codage23/projet_robocup_2023/map mind du projet/mapmind des enfants.jpg

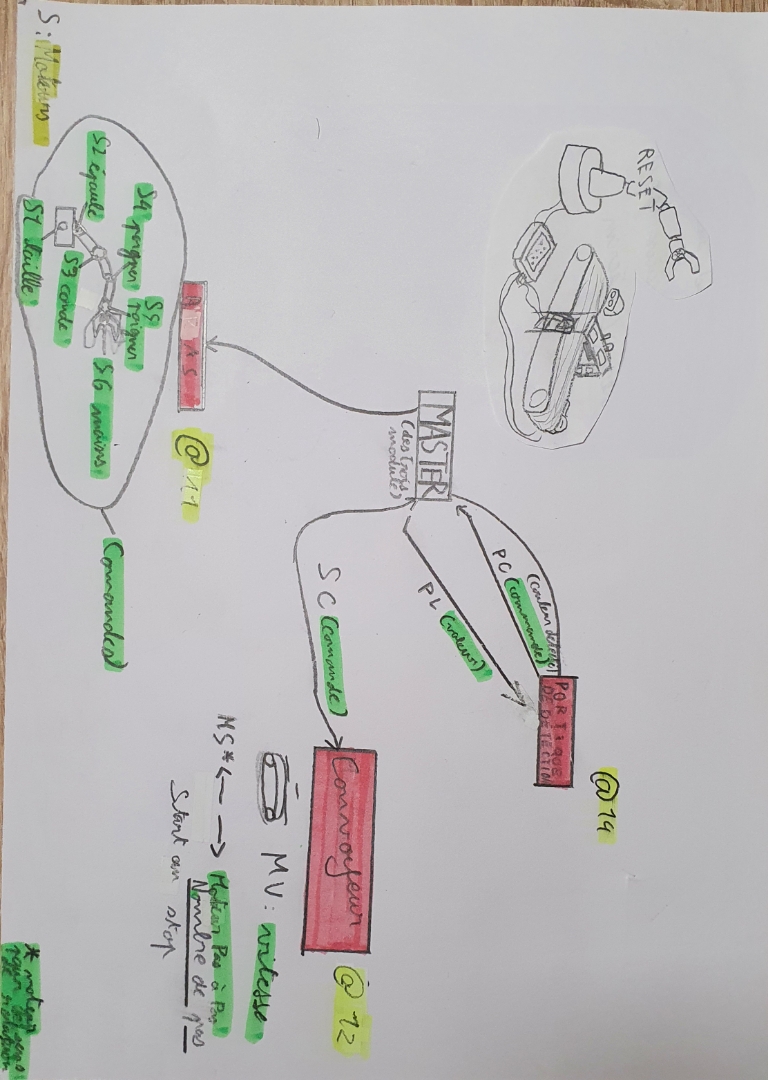
map mind du projet/mapmind des enfants.jpg
