codage23/projet_robocup_2023/projet robocup junior 2023 bras articule/projet bras articule/bras articule - liens.pdf

## Bras articule

## Liens

https://www.eagle-robotics.com/blog/4-bras-robot-6-axes-arduino---montage-et-programmation

https://learn.adafruit.com/adafruit-16-channel-pwm-slash-servo-shield?view=all

https://howtomechatronics.com/tutorials/arduino/diy-arduino-robot-arm-with-smartphone-control/
