codage23/projet_robocup_2023/projet robocup junior 2023 portique de dectection/detecteur couleurs/tcs3200_liens.pdf

TCS3200

http://electroniqueamateur.blogspot.com/2020/09/capteur-de-couleurs-tcs3200-gy-31-et.html (http://electroniqueamateur.blogspot.com/2020/09/capteur-de-couleurs-tcs3200-gy-31-et.html)

https://randomnerdtutorials.com/arduino-color-sensor-tcs230-tcs3200/

https://acoptex.com/project/2997/basics-project-078a-tcs230-or-tcs3200-color-sensor-atlex-c/ (https://acoptex.com/project/2997/basics-project-078a-tcs230-or-tcs3200-color-sensor-at-lex-c/)

https://www.electroschematics.com/get-better-with-tcs3200-color-sensor-module/

https://wiki-dfrobot-com.translate.goog/TCS3200_Color_Sensor__SKU_SEN0101_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 (https://wiki-dfrobot-com.translate.goog/TCS3200_Color_Sensor__SKU_SEN0101_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)

http://wiki.sunfounder.cc/index.php?title=Color_Sensor_Module

http://wiki.sunfounder.cc/index.php?title=TCS3200_Color_Sensor_Module

https://win.adrirobot.it/sensori/TCS3200_RGB_sensor/TCS3200_RGB_Color_Sensor.htm

https://circuitdigest.com/microcontroller-projects/interfacing-color-sensor-with-arduino

https://wiki.keyestudio.com/Ks0053_keyestudio_Color_Sensor

https://howtomechatronics.com/projects/arduino-color-sorter-project/
