codage23/projet_robocup_2023/liaisons i2c entre modules et master.pdf

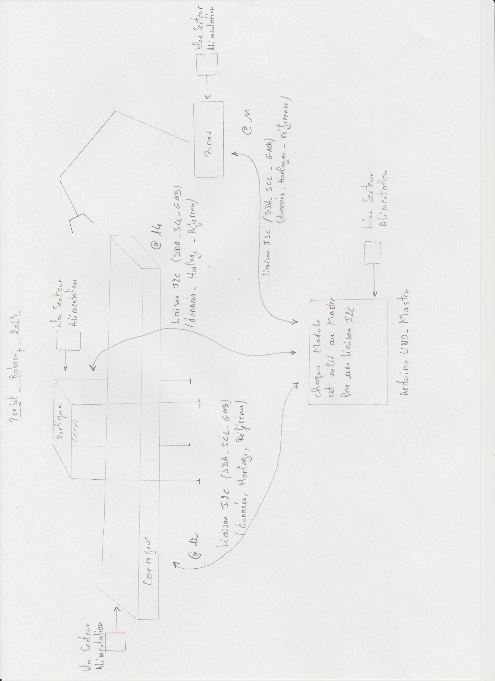
[picture p16: page 1]
