codage23/projet_robocup_2023/organigramme du projet robocup 2023.pdf

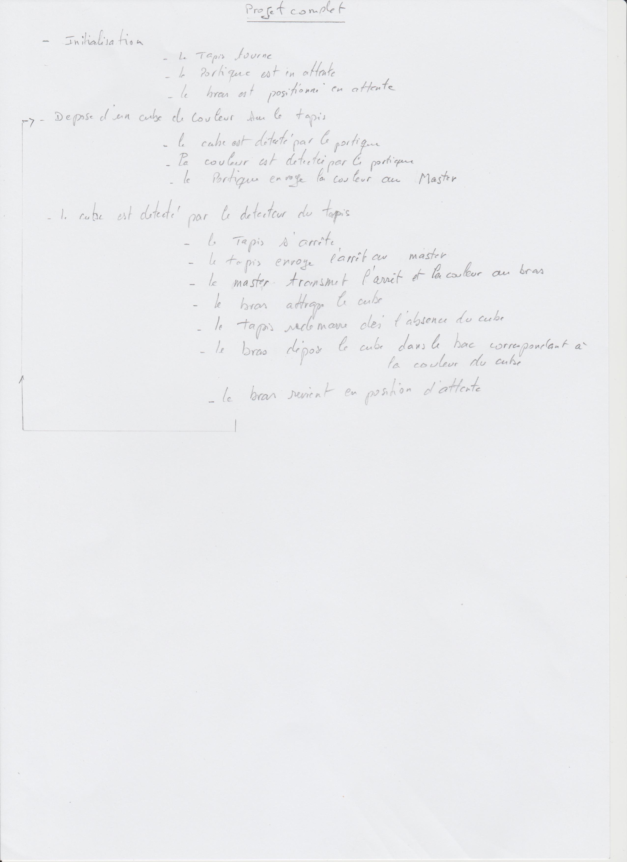
[picture p17: page 1]
