codage23/projet_robocup_2023/article_presse.pdf

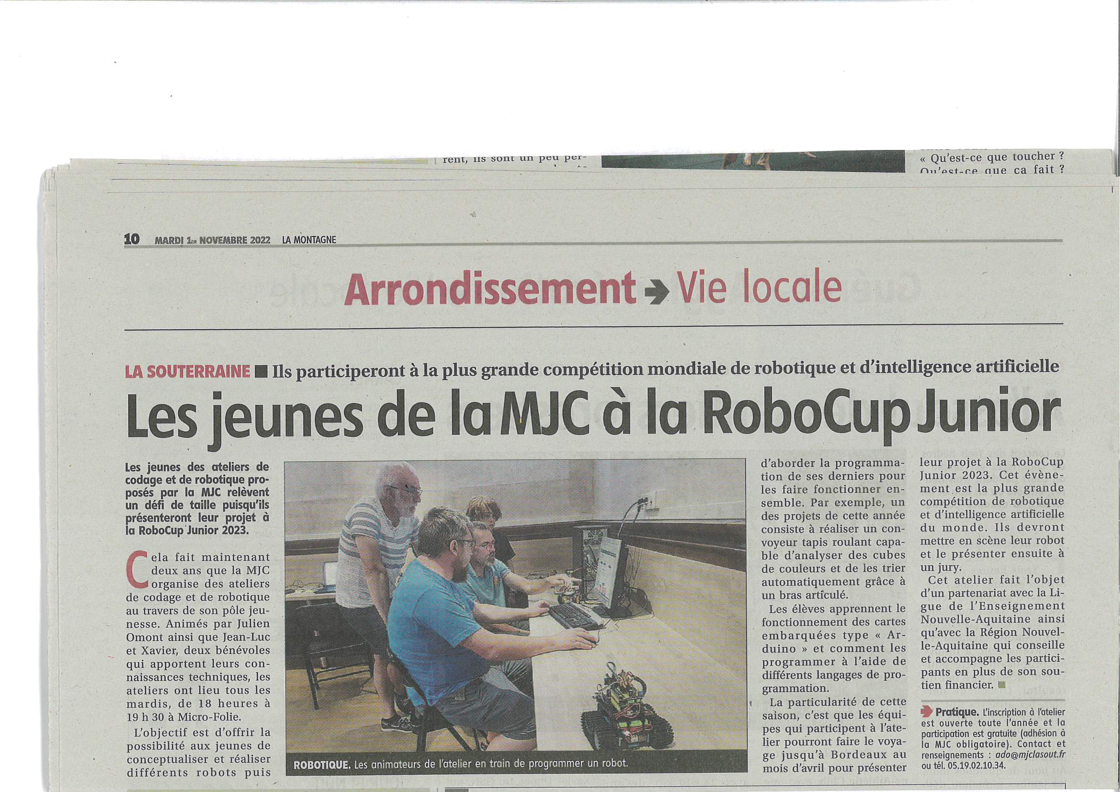
[picture p18: page 1]
