codage23/projet_robocup_2023/schema electrique/bras articule - schema electrique.pdf

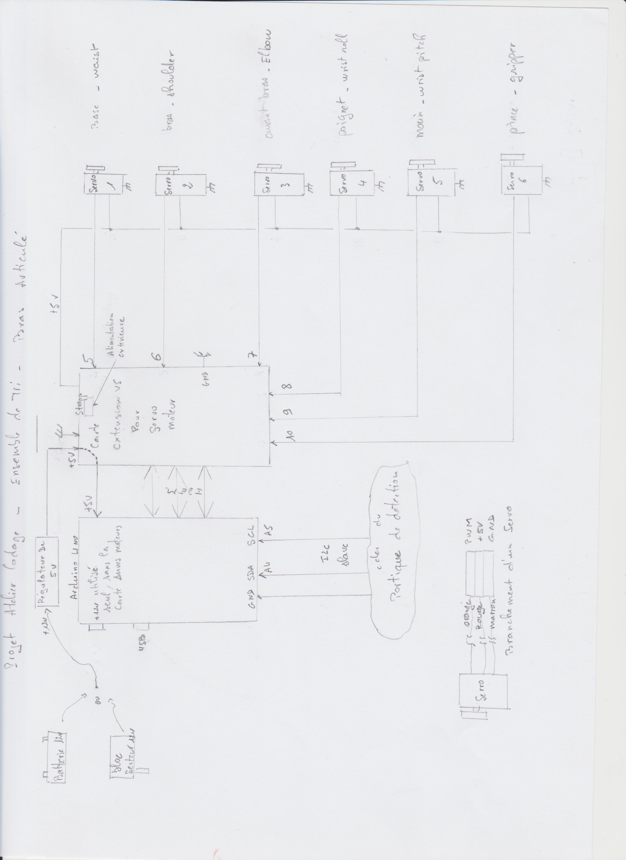
[picture p19: page 1]
