codage23/projet_robocup_2023/schema electrique/portique de detection - schema electrique.pdf

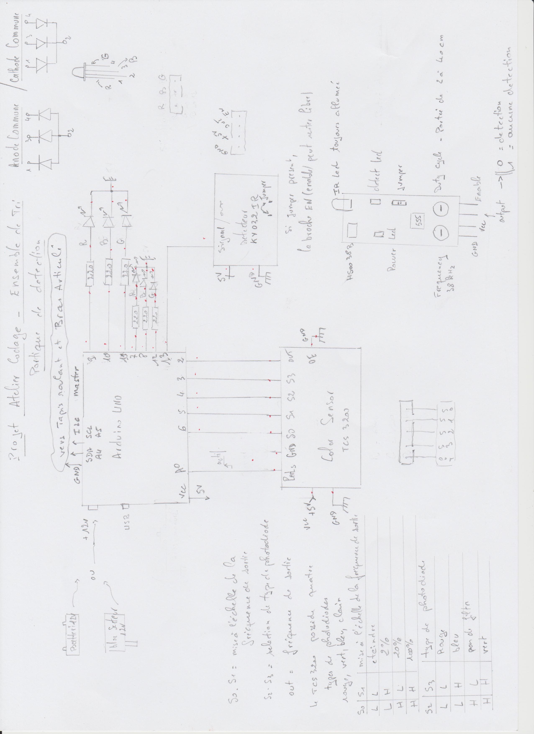
[picture p20: page 1]
