codage23/projet_robocup_2023/schema electrique/tapis roulant - convoyeur - schema electrique.pdf

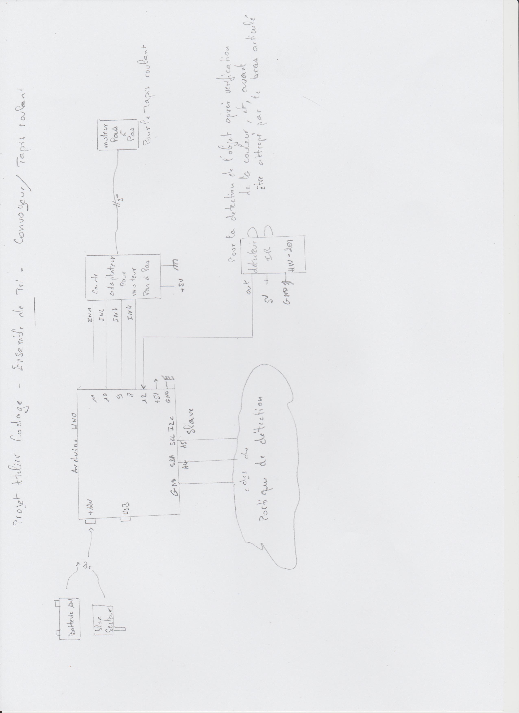
[picture p21: page 1]
