codage23/projet_robocup_2023/map mind du projet/projet atelier codage 2022 2023.pdf

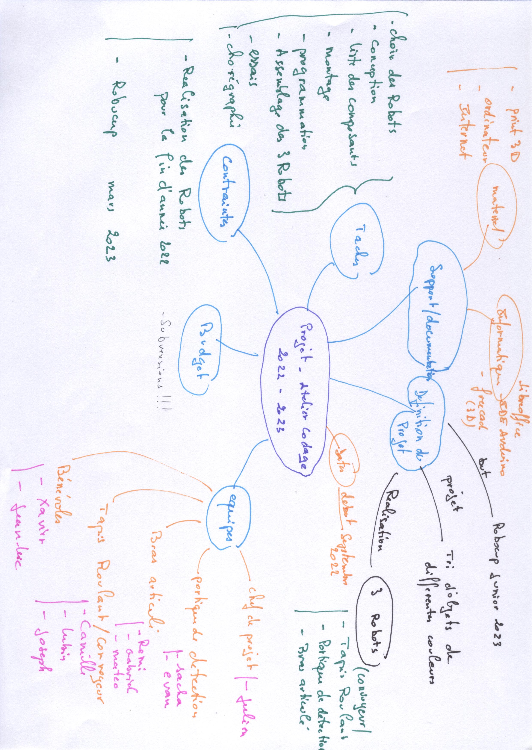
[picture p22: page 1]
