codage23/projet_robocup_2023/map mind du projet/projet atelier codage bras articule 2022 2023.pdf

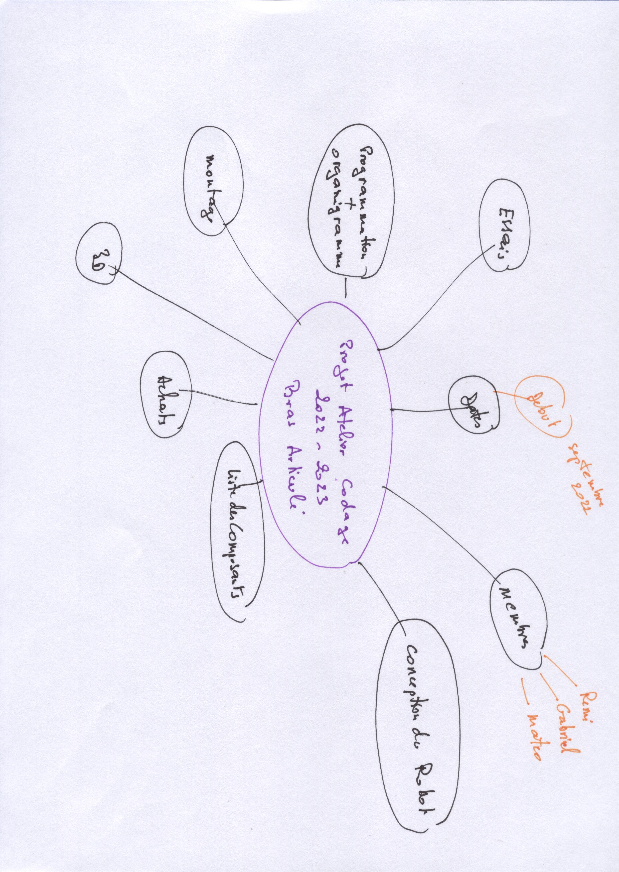
[picture p23: page 1]
