codage23/projet_robocup_2023/map mind du projet/projet atelier codage convoyeur 2022 2023.pdf

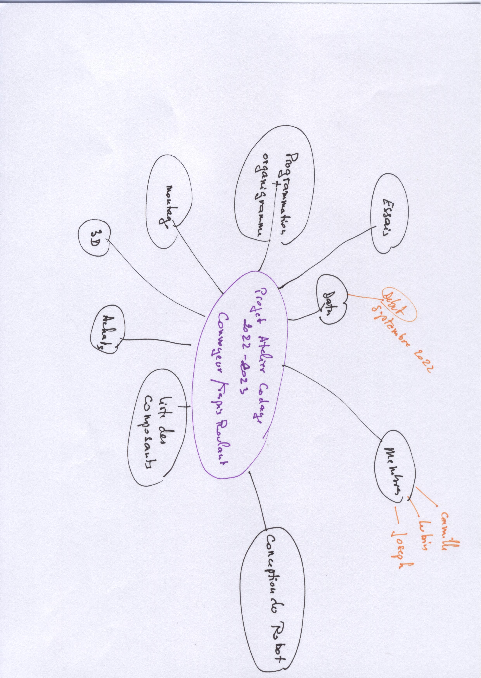
[picture p24: page 1]
