codage23/projet_robocup_2023/map mind du projet/projet atelier codage portique de detection 2022 2023.pdf

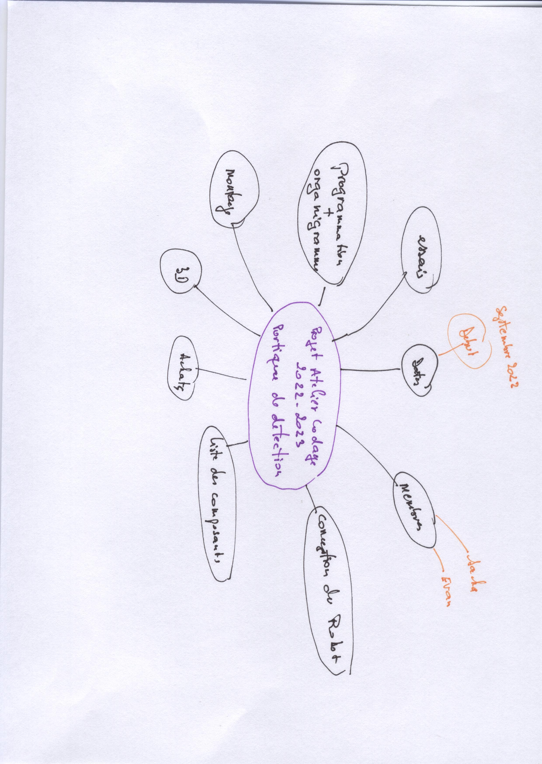
[picture p25: page 1]
