codage23/projet_robocup_2023/schema de principe/bras articule.pdf

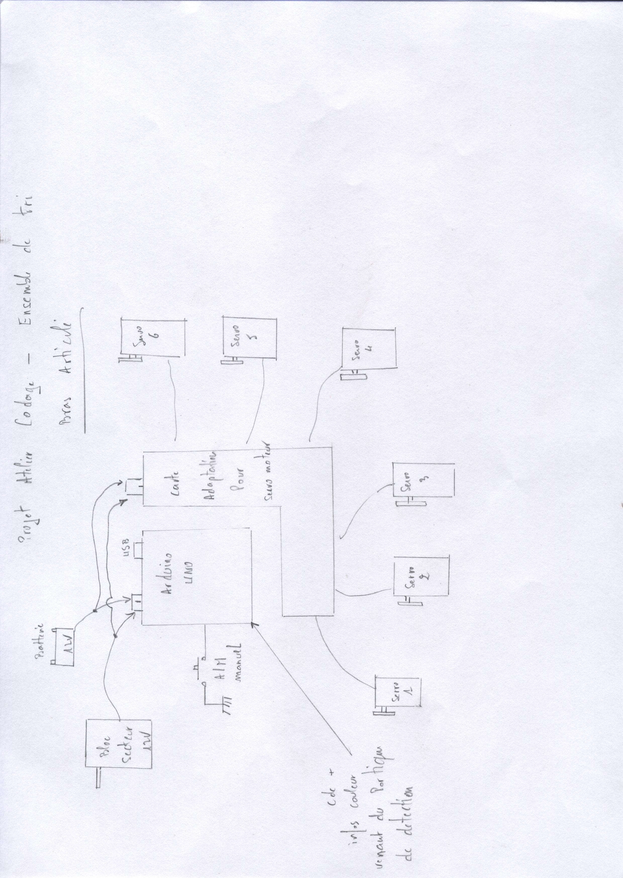
[picture p26: page 1]
