codage23/projet_robocup_2023/schema de principe/portique de detection.pdf

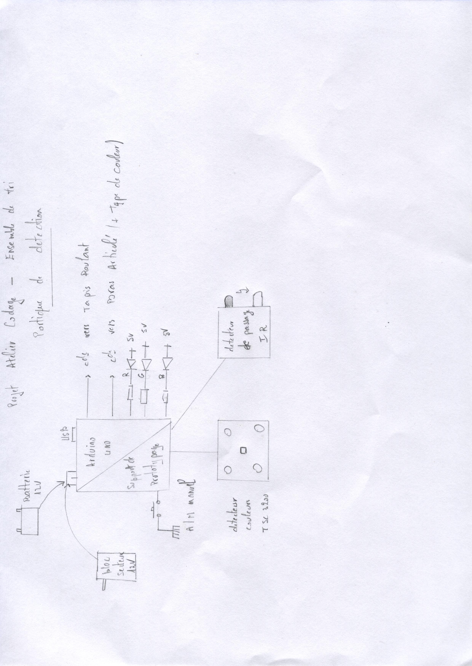
[picture p27: page 1]
