codage23/projet_robocup_2023/schema de principe/tapis roulant - convoyeur.pdf

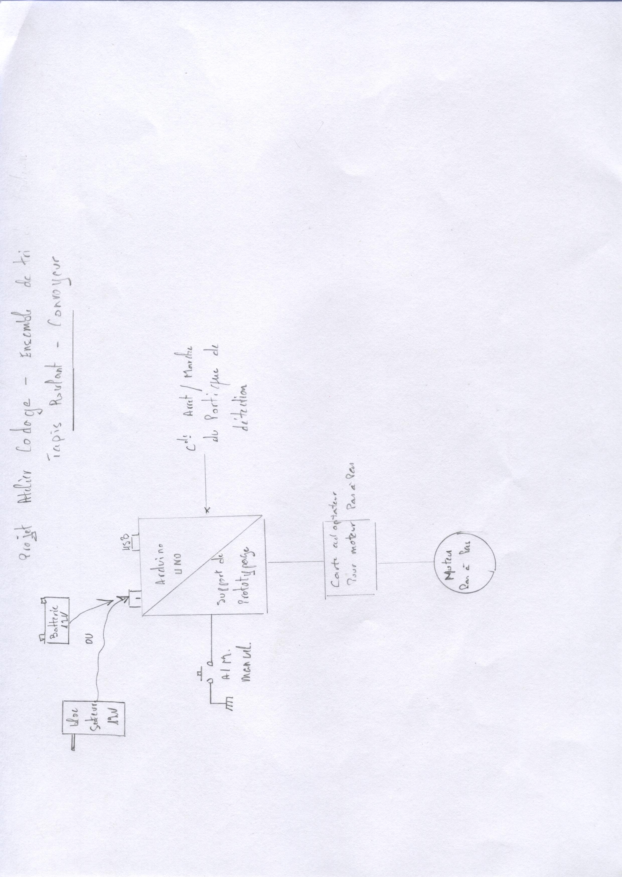
[picture p28: page 1]
