codage23/projet_robocup_2023/projet robocup junior 2023 portique de dectection/detecteur couleurs/DetectorColor.jpg

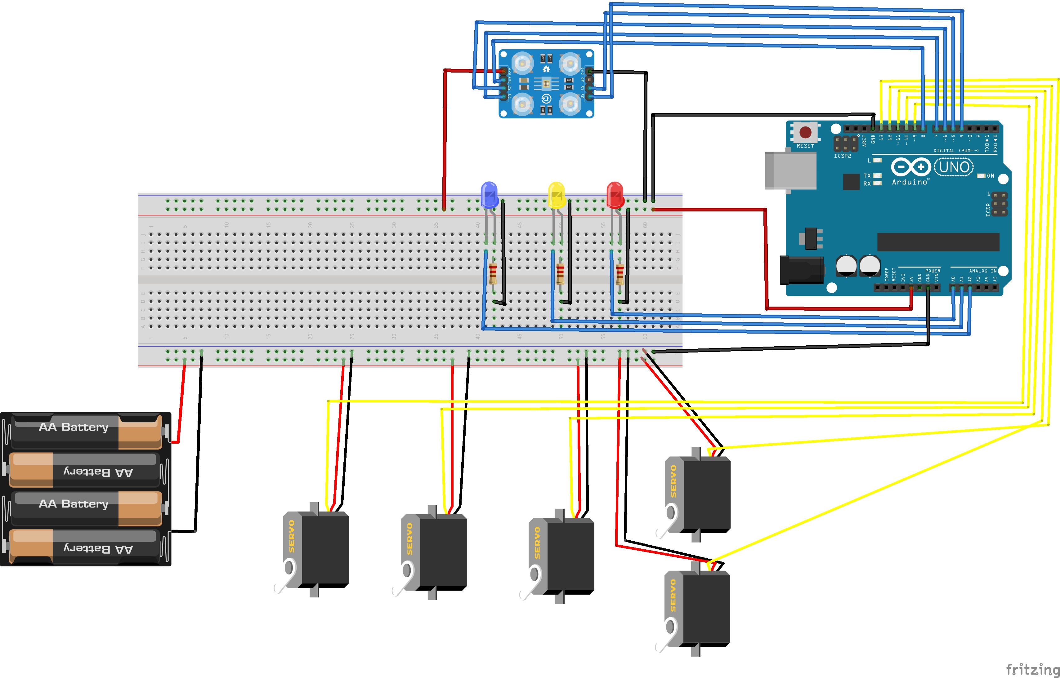
projet robocup junior 2023 portique de dectection/detecteur couleurs/DetectorColor.jpg
