codage23/projet_robocup_2023/projet robocup junior 2023 tapis roulant - convoyeur/projet convoyeur/convoyeure STL/all for the small conyor.PNG

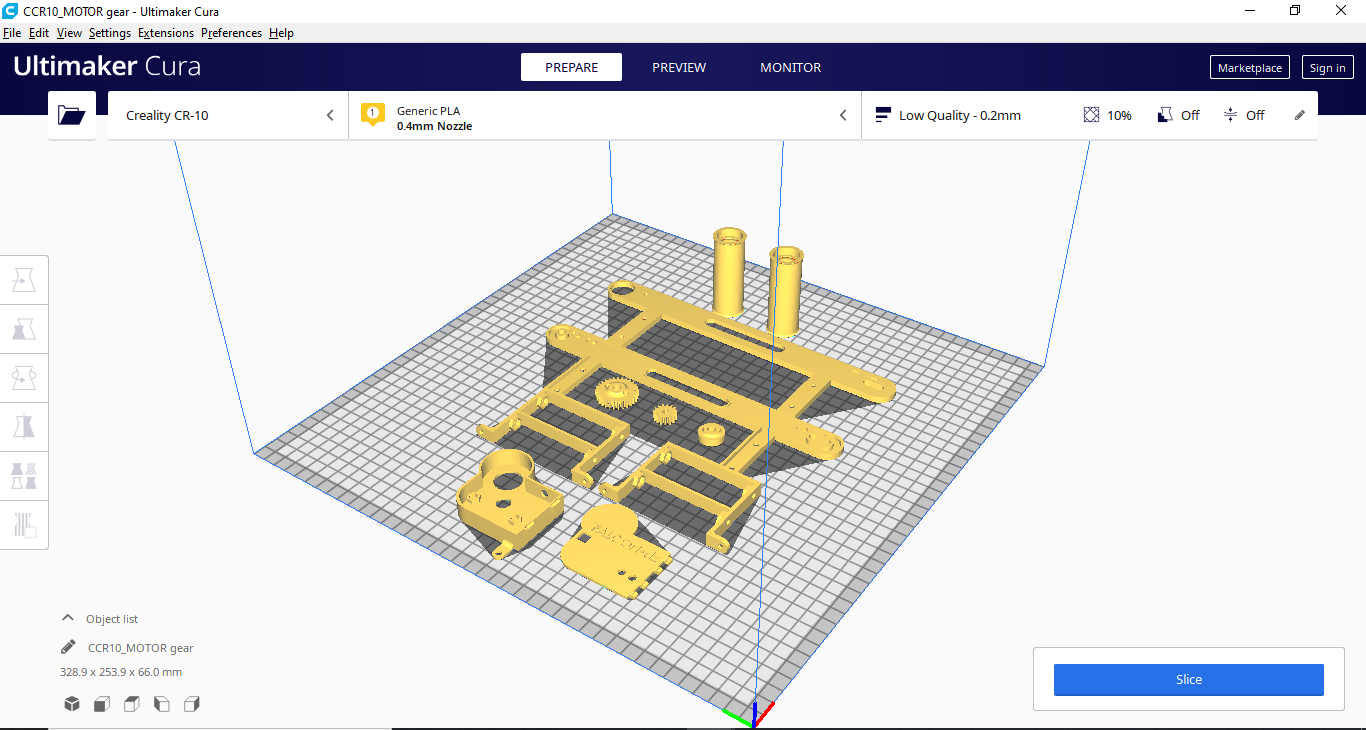
projet robocup junior 2023 tapis roulant - convoyeur/projet convoyeur/convoyeure STL/all for the small conyor.PNG
