codage23/projet_robocup_2023/achats/liste composants robocup 2022 2023.ods

nom pièce | Code produit | prix ttc | Quantite | lien
convoyeur
Carte Arduino Uno Rev3 | 1275279 - 62 | 26,99 | 1 | https://www.conrad.fr/fr/p/carte-arduino-uno-rev3-version-dip-atmega328-1275279.html
Arduino PROTO SHIELD | 1969858 - 62 | 13,99 | 1 | https://www.conrad.fr/fr/p/arduino-proto-shield-carte-de-developpement-1969858.html?vat=true
MAKERFACTORY MF-6402411 Module de commande de moteur pas à pas | 2134137 – 62 | 8,49 | 1 | https://www.conrad.fr/fr/p/makerfactory-mf-6402411-module-de-commande-de-moteur-pas-a-pas-1-pc-s-2134137.html
HN Power HNP12-120L6 Bloc d'alimentation à tension fixe 12 V/DC 1000 mA 12 W stabilisé | 1527554 – 62 | 9,49 | 1 | https://www.conrad.fr/fr/p/hn-power-hnp12-120l6-bloc-d-alimentation-a-tension-fixe-12-v-dc-1000-ma-12-w-stabilise-1527554.html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
Bearing 626 2Z Roulement | 198844 - 62 | 3,55 | 4 | https://www.conrad.fr/fr/p/ubc-bearing-626-2z-roulement-a-billes-radial-6-mm-exterieur-19-mm-regime-max-32000-tr-min-198844.html
Vis hexagonales 100 pc(s) M4 25 mm | 130626 - 62 | 6,99 | 1 | https://www.conrad.fr/fr/p/vis-hexagonales-toolcraft-130626-100-pc-s-m4-25-mm-tete-hexagonale-6-pans-exterieurs-acier-n-a-130626.html
Écrou hexagonal M4 100 pc(s) | 2287033 - 62 | 2,81 | 1 | https://www.conrad.fr/fr/p/toolcraft-to-6861099-ecrou-hexagonal-m4-din-934-acier-inoxydable-v2a-a2-100-pc-s-2287033.html
vis M3 20mm 100 pc(s) | 814733 - 62 | 2,81 | 1 | https://www.conrad.fr/fr/p/vis-cylindrique-toolcraft-814733-100-pc-s-m3-20-mm-tete-cylindrique-plat-acier-n-a-814733.html
Ecrou M3 100pcs | 2287032 - 62 | 2,81 | 1 | https://www.conrad.fr/fr/p/toolcraft-to-6861096-ecrou-hexagonal-m3-din-934-acier-inoxydable-v2a-a2-100-pc-s-2287032.html
vis M6 20mm 100pcs | 128222 - 62 | 6,49 | 1 | https://www.conrad.fr/fr/p/vis-hexagonales-toolcraft-128222-100-pc-s-m6-20-mm-tete-hexagonale-6-pans-exterieurs-acier-n-a-128222.html
Ecrou M6 100pcs | 131827 - 62 | 3,52 | 1 | https://www.conrad.fr/fr/p/ecrou-hexagonal-toolcraft-131827-acier-zingue-galvanise-de-qualite-8-m6-100-pc-s-131827.html
Bouton poussoir | 1566643 - 62 | 0,73 | 1 | https://www.conrad.fr/fr/p/tru-components-pbs-18b-701837-bouton-poussoir-a-pression-50-v-dc-ac-0-025-a-1-x-off-on-a-rappel-1-pc-s-1566643.html
tige filetee M6 85mm |  |  | 1
bras articule
Carte Arduino Uno Rev3 | 1275279 - 62 | 26,99 | 1 | https://www.conrad.fr/fr/p/carte-arduino-uno-rev3-version-dip-atmega328-1275279.html
Arduino PROTO SHIELD | 1969858 - 62 | 13,99 | 1 | https://www.conrad.fr/fr/p/arduino-proto-shield-carte-de-developpement-1969858.html?vat=true
HN Power HNP12-120L6 Bloc d'alimentation à tension fixe 12 V/DC 1000 mA 12 W stabilisé | 1527554 – 62 | 9,49 | 2 | https://www.conrad.fr/fr/p/hn-power-hnp12-120l6-bloc-d-alimentation-a-tension-fixe-12-v-dc-1000-ma-12-w-stabilise-1527554.html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
résistance 1 kohm | 1417699 – 62 | 0,08 | 10 | https://www.conrad.fr/fr/p/resistance-a-couche-carbone-yageo-cfr25j1k0h-1-k-sortie-axiale-0207-0-25-w-1-pc-s-1417699.html
servomoteur sg90 | 2148502 - 62 | 6,99 | 3 | https://www.conrad.fr/fr/p/reely-mini-servomoteur-analogique-materiau-entrainement-plastique-systeme-de-connecteur-jr-2148502.html
servomoteur mg995 | 2481920 – 62 | 11,99 | 3 | https://www.conrad.fr/fr/p/whadda-wpm603-carte-de-developpement-1-pc-s-2481920.html
Bouton poussoir | 1566643 - 62 | 0,73 | 1 | https://www.conrad.fr/fr/p/tru-components-pbs-18b-701837-bouton-poussoir-a-pression-50-v-dc-ac-0-025-a-1-x-off-on-a-rappel-1-pc-s-1566643.html
carte adaptation arduino uno servo |  |  | 1
rallonge cordon servo moteur |  |  | 6
hc05 shield bluetooth |  |  | 1
portique
Carte Arduino Uno Rev3 | 1275279 - 62 | 26,99 | 1 | https://www.conrad.fr/fr/p/carte-arduino-uno-rev3-version-dip-atmega328-1275279.html
Arduino PROTO SHIELD | 1969858 - 62 | 13,99 | 1 | https://www.conrad.fr/fr/p/arduino-proto-shield-carte-de-developpement-1969858.html?vat=true
HN Power HNP12-120L6 Bloc d'alimentation à tension fixe 12 V/DC 1000 mA 12 W stabilisé | 1527554 – 62 | 9,49 | 1 | https://www.conrad.fr/fr/p/hn-power-hnp12-120l6-bloc-d-alimentation-a-tension-fixe-12-v-dc-1000-ma-12-w-stabilise-1527554.html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
SEN-KY032IR | 2306254 - 62 | 3,28 | 1 | https://www.conrad.fr/fr/p/joy-it-sen-ky032ir-emetteur-infrarouge-ir-1-pc-s-convient-pour-kits-de-developpement-arduino-micro-bit-raspberry-2306254.html
Colorimeter TCS3200 | 1503748 – 62 | 13,99 | 1 | https://www.conrad.fr/fr/p/carte-d-extension-arduino-joy-it-colorimeter-tcs3200-noir-1-pc-s-1503748.html
Led multicolore 5mm | 1050466 - 62 | 1,09 | 5 | https://www.conrad.fr/fr/p/kingbright-l-154a4surkqbdzgw-led-multicolore-rouge-bleu-vert-rond-5-mm-200-mcd-300-mcd-1300-mcd-60-20-ma-1-95-v-1050466.html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
Bouton poussoir | 1566643 - 62 | 0,73 | 1 | https://www.conrad.fr/fr/p/tru-components-pbs-18b-701837-bouton-poussoir-a-pression-50-v-dc-ac-0-025-a-1-x-off-on-a-rappel-1-pc-s-1566643.html
Resistance 220 ohm | 1584804 - 62 | 0,11 | 10 | https://www.conrad.fr/fr/p/resistance-a-couche-carbone-tru-components-tc-cfr0w4j0221a50203-1584804-220-sortie-axiale-0207-0-25-w-1-pc-s-1584804.html
