codage23/projet_robocup_2023/projet robocup junior 2023 bras articule/projet bras articule/bras articule/fabriziomaylle/diy-arduino-robot-arm-with-smartphone-control/gear2.stl

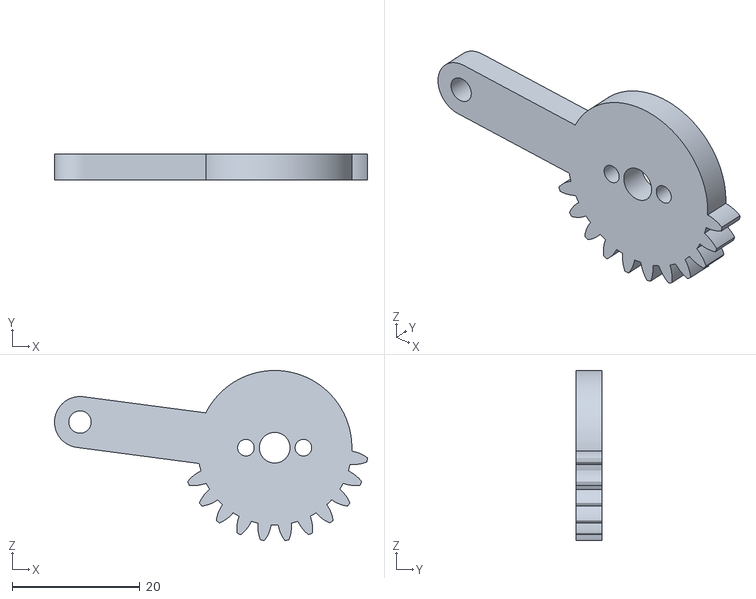
[picture p31: CAD file, 2022-11-23]
projet robocup junior 2023 bras articule/projet bras articule/bras articule/fabriziomaylle/diy-arduino-robot-arm-with-smartphone-control/gear2.stl
49.0 x 4.00 x 26.6
