codage23/projet_robocup_2023/projet robocup junior 2023 portique de dectection/3d/tcs3200 protection.fcstd

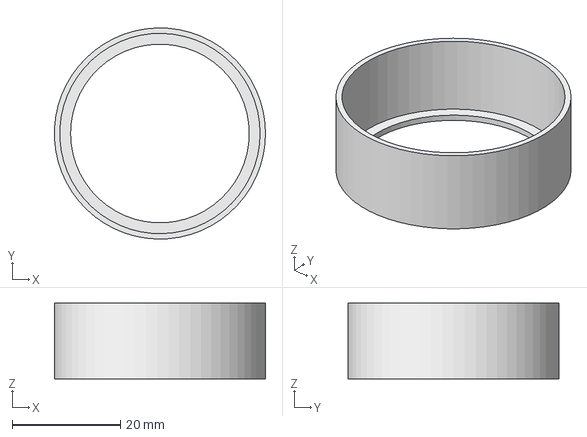
[picture p32: CAD file, 2023-01-16]
projet robocup junior 2023 portique de dectection/3d/tcs3200 protection.fcstd
39.0 x 39.0 x 14.0 mm
