codage23/projet_robocup_2023/projet robocup junior 2023 tapis roulant - convoyeur/projet convoyeur/convoyeure STL/chassie.STL

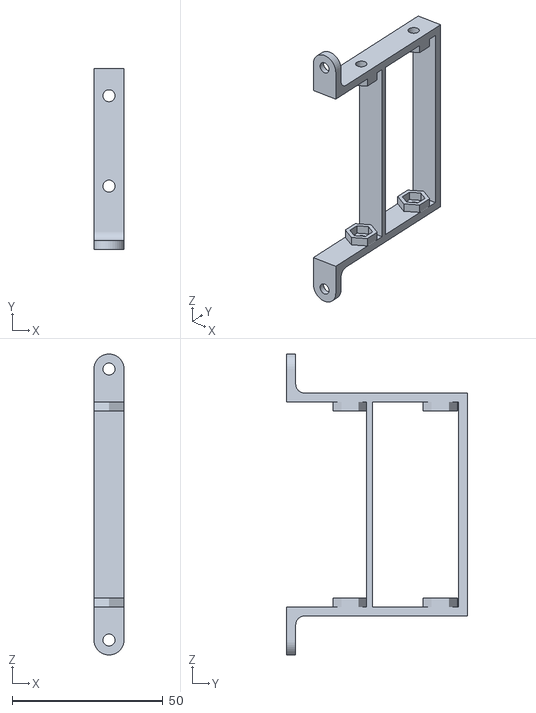
[picture p33: CAD file, 2022-11-23]
projet robocup junior 2023 tapis roulant - convoyeur/projet convoyeur/convoyeure STL/chassie.STL
10.0 x 60.0 x 100.0
