codage23/projet_robocup_2023/projet robocup junior 2023 tapis roulant - convoyeur/projet convoyeur/Make_it_small/conveyor-conveyor-belt/convoyeure STL/right corp L 230mm.STL

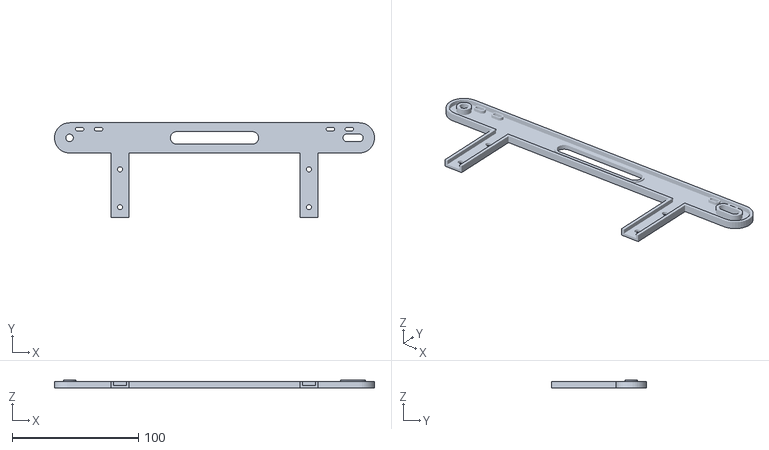
[picture p34: CAD file, 2022-11-23]
projet robocup junior 2023 tapis roulant - convoyeur/projet convoyeur/Make_it_small/conveyor-conveyor-belt/convoyeure STL/right corp L 230mm.STL
253.9 x 75.0 x 6.00
