codage23/projet_robocup_2023/projet robocup junior 2023 tapis roulant - convoyeur/projet convoyeur/Make_it_small/conveyor-conveyor-belt/support IR.STL

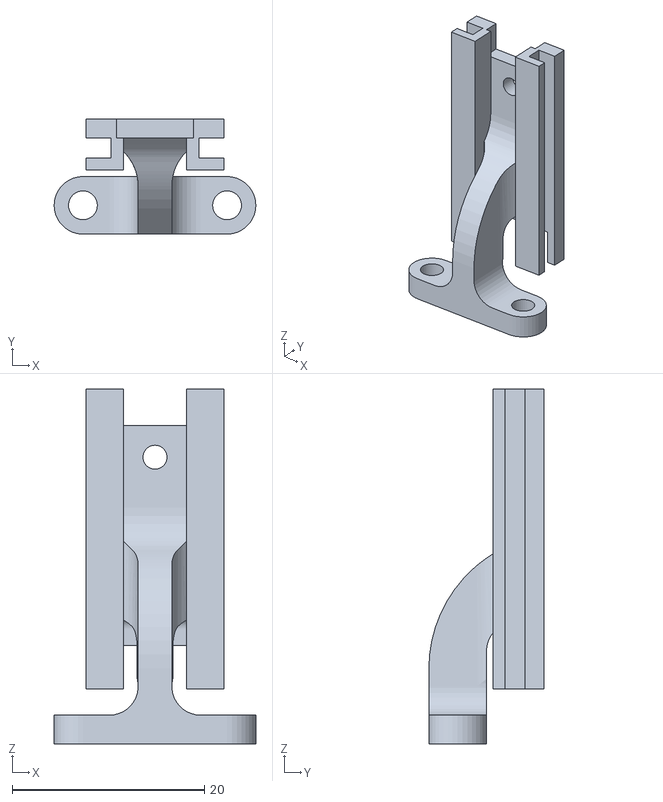
[picture p35: CAD file, 2022-11-23]
projet robocup junior 2023 tapis roulant - convoyeur/projet convoyeur/Make_it_small/conveyor-conveyor-belt/support IR.STL
21.0 x 12.0 x 36.9
