codage23/projet_robocup_2023/projet robocup junior 2023 bras articule/projet bras articule/bras articule/fabriziomaylle/diy-arduino-robot-arm-with-smartphone-control/Arm 02 v3.stl

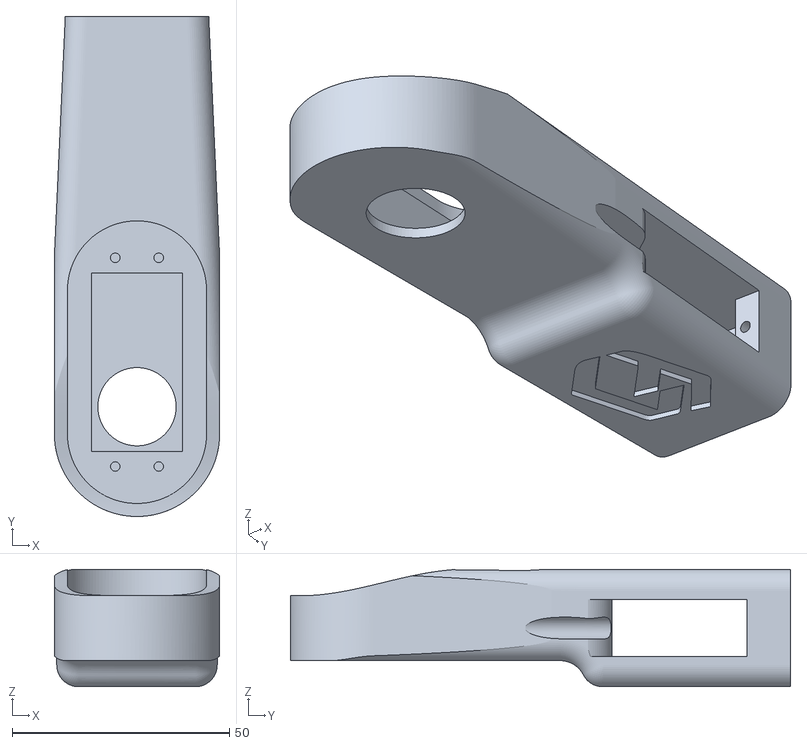
[picture p36: CAD file, 2022-11-23]
projet robocup junior 2023 bras articule/projet bras articule/bras articule/fabriziomaylle/diy-arduino-robot-arm-with-smartphone-control/Arm 02 v3.stl
38.0 x 115.0 x 27.0
