codage23/projet_robocup_2023/projet robocup junior 2023 portique de dectection/3d/portique 3D.FCStd

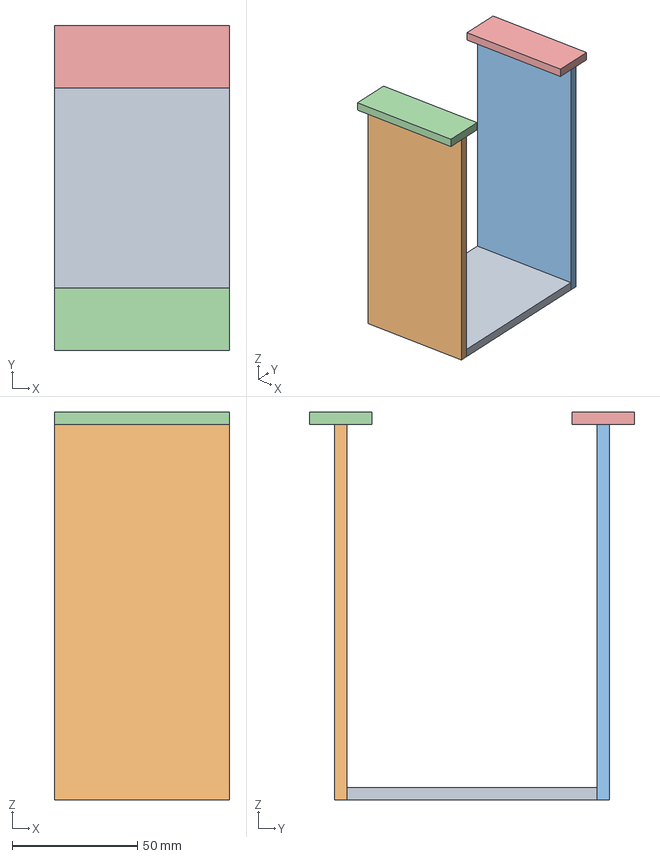
[picture p37: CAD file, 2022-11-23]
projet robocup junior 2023 portique de dectection/3d/portique 3D.FCStd
70.0 x 130.0 x 155.0 mm
