codage23/projet_robocup_2023/projet robocup junior 2023 tapis roulant - convoyeur/projet convoyeur/Make_it_small/conveyor-conveyor-belt/convoyeure STL/roulou.STL

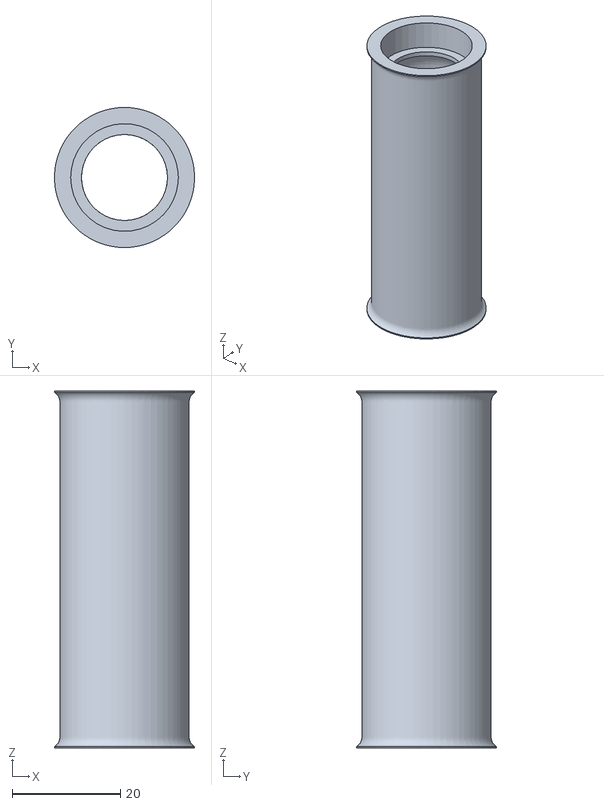
[picture p38: CAD file, 2022-11-23]
projet robocup junior 2023 tapis roulant - convoyeur/projet convoyeur/Make_it_small/conveyor-conveyor-belt/convoyeure STL/roulou.STL
25.9 x 25.9 x 66.0
