codage23/projet_robocup_2023/projet robocup junior 2023 tapis roulant - convoyeur/projet convoyeur/Make_it_small/conveyor-conveyor-belt/cover supporte IR.STL

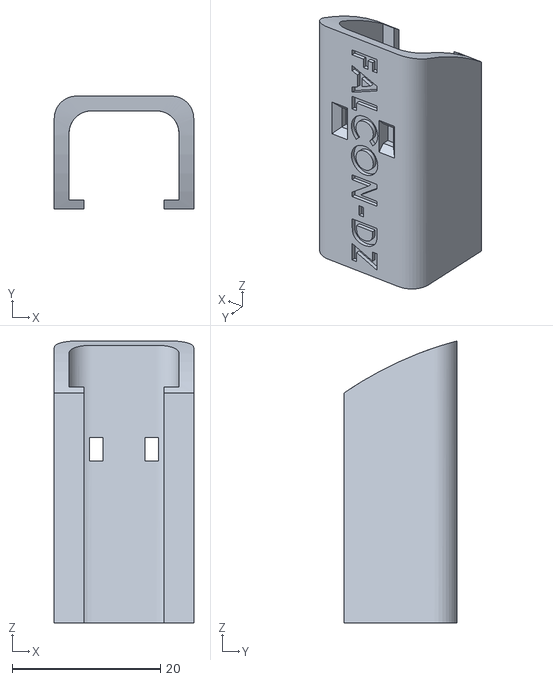
[picture p39: CAD file, 2022-11-23]
projet robocup junior 2023 tapis roulant - convoyeur/projet convoyeur/Make_it_small/conveyor-conveyor-belt/cover supporte IR.STL
18.8 x 15.2 x 38.0
