codage23/projet_robocup_2023/projet robocup junior 2023 bras articule/projet bras articule/bras articule/fabriziomaylle/diy-arduino-robot-arm-with-smartphone-control/Gripper base.stl

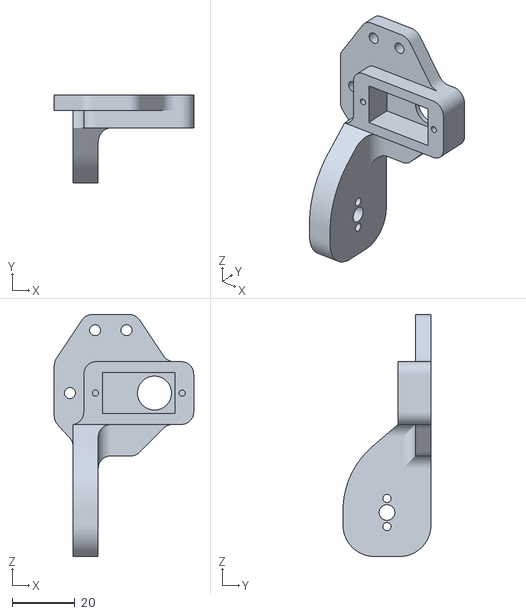
[picture p40: CAD file, 2022-11-23]
projet robocup junior 2023 bras articule/projet bras articule/bras articule/fabriziomaylle/diy-arduino-robot-arm-with-smartphone-control/Gripper base.stl
44.4 x 28.0 x 77.0
