codage23/projet_robocup_2023/projet robocup junior 2023 portique de dectection/3d/portique mesh.stl

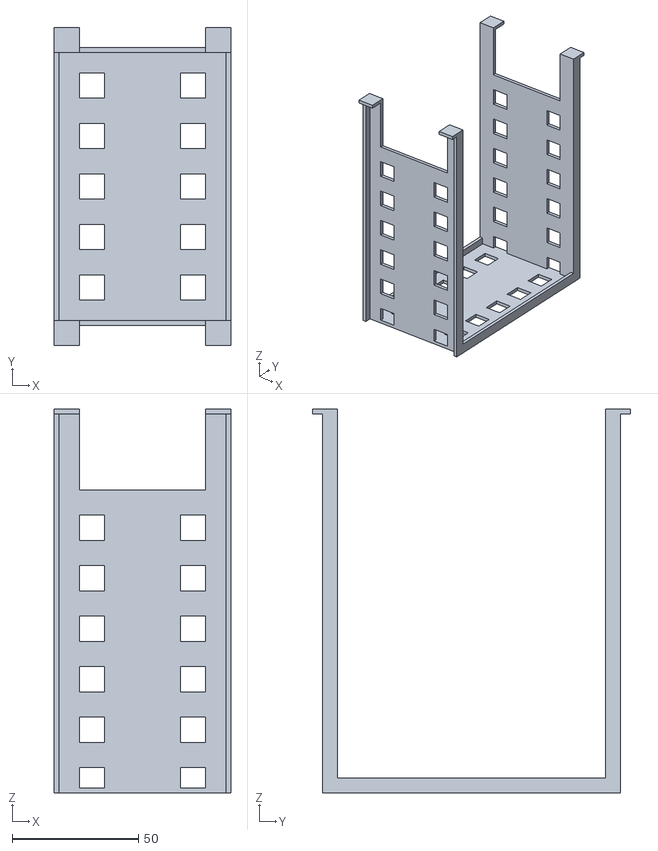
[picture p41: CAD file, 2022-11-23]
projet robocup junior 2023 portique de dectection/3d/portique mesh.stl
70.0 x 126.0 x 152.0
