codage23/projet_robocup_2023/projet robocup junior 2023 tapis roulant - convoyeur/projet convoyeur/convoyeure STL/steper support gear box.STL

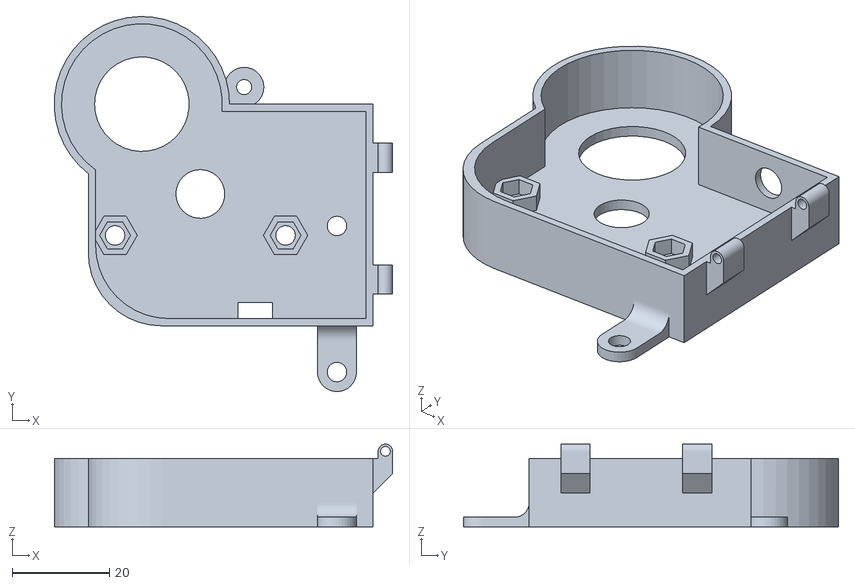
[picture p42: CAD file, 2022-11-23]
projet robocup junior 2023 tapis roulant - convoyeur/projet convoyeur/convoyeure STL/steper support gear box.STL
69.5 x 77.0 x 17.0
