codage23/projet_robocup_2023/projet robocup junior 2023 tapis roulant - convoyeur/projet convoyeur/Make_it_small/conveyor-conveyor-belt/prodact.STL

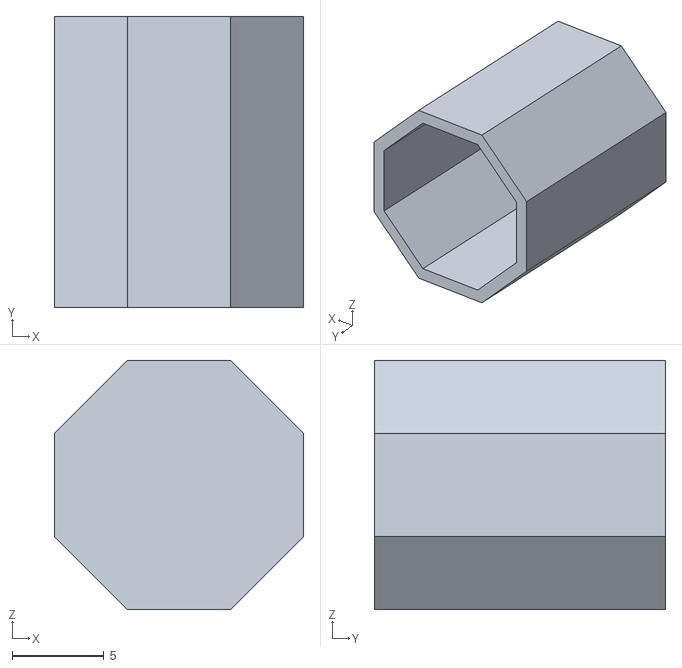
[picture p43: CAD file, 2022-11-23]
projet robocup junior 2023 tapis roulant - convoyeur/projet convoyeur/Make_it_small/conveyor-conveyor-belt/prodact.STL
13.6 x 15.9 x 13.6
