codage23/projet_robocup_2023/projet robocup junior 2023 bras articule/projet bras articule/bras articule/fabriziomaylle/diy-arduino-robot-arm-with-smartphone-control/Gripper 2.stl

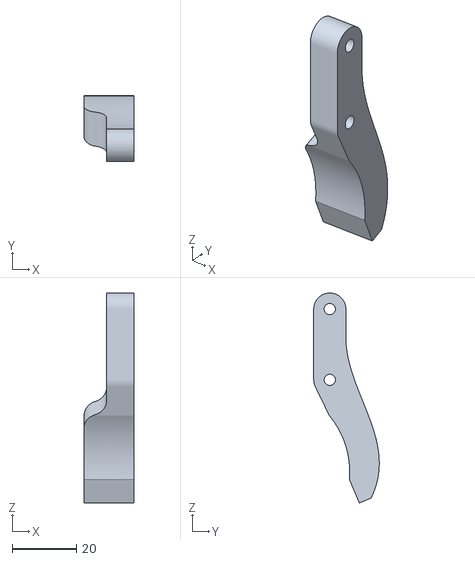
[picture p44: CAD file, 2022-11-23]
projet robocup junior 2023 bras articule/projet bras articule/bras articule/fabriziomaylle/diy-arduino-robot-arm-with-smartphone-control/Gripper 2.stl
15.5 x 20.4 x 65.3
