codage23/projet_robocup_2023/projet robocup junior 2023 portique de dectection/3d/portique.fcstd

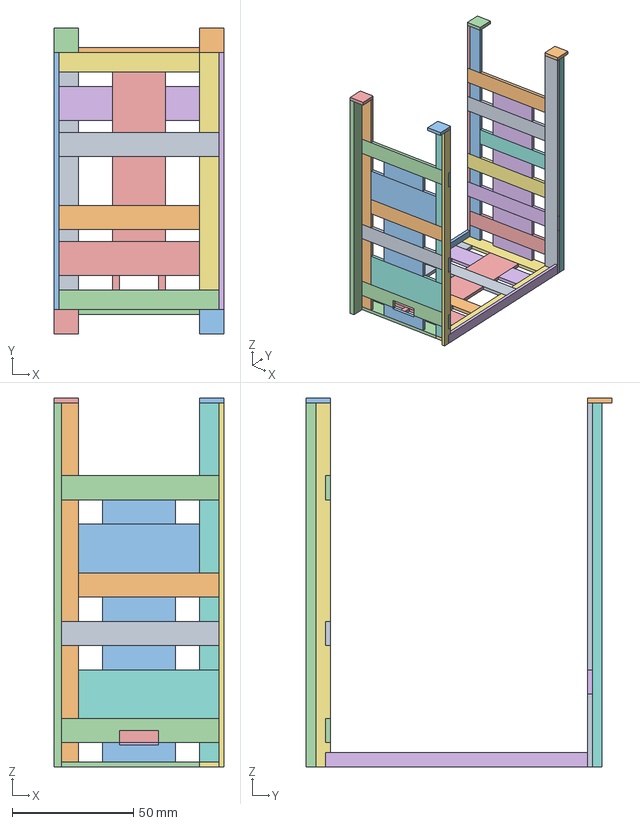
[picture p45: CAD file, 2022-11-23]
projet robocup junior 2023 portique de dectection/3d/portique.fcstd
70.0 x 126.0 x 152.0 mm
Cube haut
Cube haut001
Cube haut002
Cube haut003
