codage23/projet_robocup_2023/projet robocup junior 2023 tapis roulant - convoyeur/projet convoyeur/convoyeure STL/MOTOR gear.STL

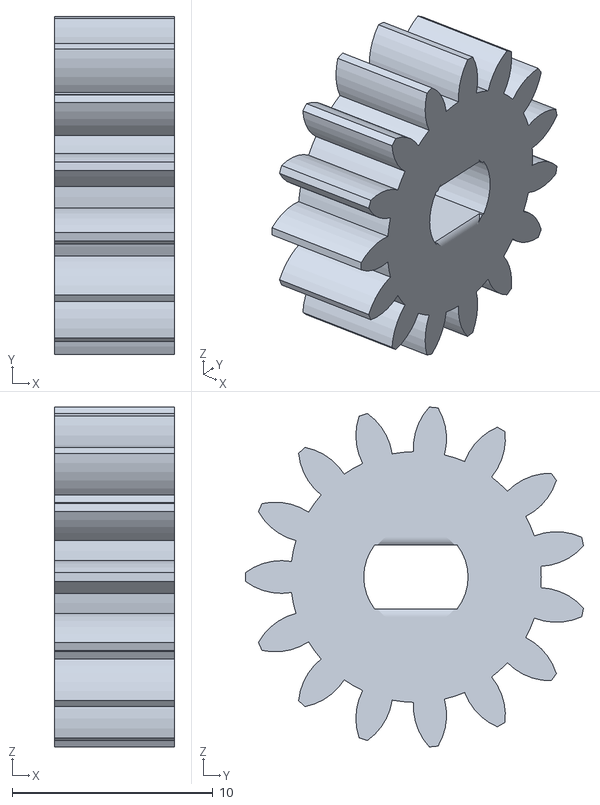
[picture p46: CAD file, 2022-11-23]
projet robocup junior 2023 tapis roulant - convoyeur/projet convoyeur/convoyeure STL/MOTOR gear.STL
6.00 x 16.9 x 16.9
