codage23/projet_robocup_2023/projet robocup junior 2023 bras articule/projet bras articule/bras articule/fabriziomaylle/diy-arduino-robot-arm-with-smartphone-control/Arm 01.stl

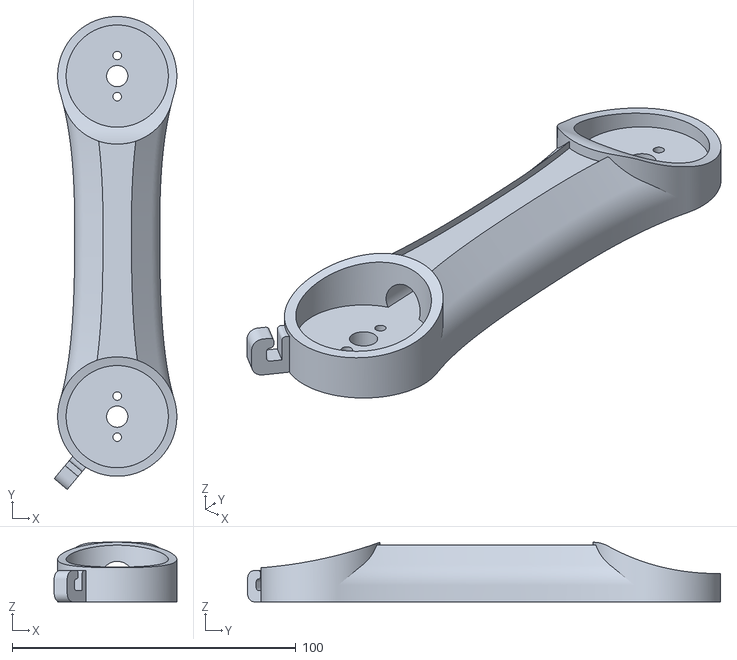
[picture p48: CAD file, 2022-11-23]
projet robocup junior 2023 bras articule/projet bras articule/bras articule/fabriziomaylle/diy-arduino-robot-arm-with-smartphone-control/Arm 01.stl
43.2 x 166.7 x 21.0
