codage23/projet_robocup_2023/projet robocup junior 2023 tapis roulant - convoyeur/projet convoyeur/convoyeure STL/coupling .STL

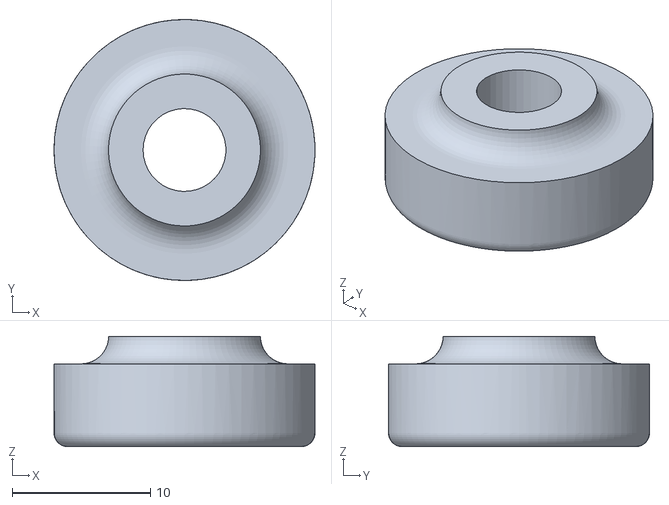
[picture p53: CAD file, 2022-11-23]
projet robocup junior 2023 tapis roulant - convoyeur/projet convoyeur/convoyeure STL/coupling .STL
18.9 x 18.9 x 8.00
