codage23/projet_robocup_2023/(list of files, cad)

Other CAD files:
projet robocup junior 2023 bras articule/projet bras articule/bras articule/fabriziomaylle/diy-arduino-robot-arm-with-smartphone-control/Gripper 1.stl
projet robocup junior 2023 bras articule/projet bras articule/bras articule/fabriziomaylle/diy-arduino-robot-arm-with-smartphone-control/gear1.stl
projet robocup junior 2023 portique de dectection/3d/portique 3d.stl
projet robocup junior 2023 portique de dectection/3d/portique.stl
projet robocup junior 2023 portique de dectection/3d/tcs3200 protection.stl
