codage23/projet_robocup_2023/projet robocup junior 2023 bras articule/projet bras articule/Bras_Robotique_easing/variables.h

//========================================================
// Controls supression of the MonPrintf function to serial
//========================================================
#define SERIAL_BAUD 115200   // vitesse moniteur serie
#define SerialMonitor   1
#define debug 1  // true for use Display log message if True

//========================================================
// Differentes fonctions du programme
//========================================================
#define TEST  0        // if 1 true,  0 false
#define I2C  1         // if 1 true,  0 false

//==========================================
// Affectation des broches de l'arduino uno
//==========================================
#define WAIST 5
#define SHOULDER 6
#define ELBOW 7
#define WRIST_ROLL 8
#define WRIST_PITCH 9
#define GRIPPER 10

//==================================================
// Definition de l'adresse logique de l'esclave I2C
//==================================================
#define I2C_SLAVE_BRAS  11

//==========
// Variables
//==========
//==================
// current position
//==================
int servo1Pos, servo2Pos, servo3Pos, servo4Pos, servo5Pos, servo6Pos;

//==================
// previous position
//==================
int servo1PPos, servo2PPos, servo3PPos, servo4PPos, servo5PPos, servo6PPos;

//=============================
// for storing positions/steps
//=============================
int servo01SP[50], servo02SP[50], servo03SP[50], servo04SP[50], servo05SP[50], servo06SP[50];

int speedDelay = 20;
int index = 0;
String dataIn = "";
int dataI2C = 0;
int speedServo = 30;

const unsigned int MAX_MESSAGE_LENGTH = 32;
static char message[MAX_MESSAGE_LENGTH]; // longueur maxi du message I2C


//===========================
// Robot arm initial position
//===========================
#define PP_WAIST 90
#define PP_SHOULDER 160
#define PP_ELBOW 100
#define PP_WRIST_ROLL 100
#define PP_WRIST_PITCH 70
#define PP_GRIPPER 100
