codage23/projet_robocup_2023/(commit log)

2022-11-23 init projet robocup junior 2023 bordeaux
    [Arm 01.stl, Arm 02 v3.stl, Arm 03.stl, Base.stl, Gripper 1.stl, Gripper 2.stl, Gripper base.stl, MOTOR gear.STL]
2022-11-30 codes ino portique led et ir
2022-12-02 doc arduino sensor shield v5
2022-12-02 wiring arduino uno
2022-12-03 schema electrique de chaque partie du projet
2022-12-03 mise a jour de la documentation
2022-12-05 mise a jour des liens
2022-12-07 test ky032 du portique de detection
2022-12-20 bras robotique - modification des liaisons avec l'arduino
2022-12-22 bras articule - modification des liaisons sur le schema electrique - et - organigramme du projet
2022-12-26 bras avec i2c
2022-12-27 modification des valeurs demarrage du bras
2022-12-31 bras articule et la gestion des trois modules grace a la liaison i2c
2023-01-02 convoyeur arduino
2023-01-04 convoyeur avec i2c
2023-01-04 test tcs3200 detecteur de couleurs
2023-01-06 reglages detecteur de couleurs
2023-01-07 assemblage du portique et essais
2023-01-09 portique i2c
2023-01-10 portique i2c request
2023-01-12 bon fonctionnement du portique et modification du nom fichier master des trois modules
2023-01-12 projet avec liste des commandes et modifications du convoyeur et noms de fichiers
2023-01-16 protection tcs3200 detecteur de lumiere
    [tcs3200 protection.fcstd, tcs3200 protection.stl]
2023-01-18 ralentir le bras par des boucles for, et , master avec un fichier variables et un fichier fonctions
2023-01-19 scan documents et creation de dossiers
    [liste composants robocup 2022 2023.ods]
2023-01-26 arduino master i2c
2023-01-29 projet convoyeur correction stop et start
    [convoyeur_arduino.ino, master_des_trois_modules.ino, portique_de_detection.ino]
2023-03-01 programme master finalise par les enfants
2023-03-17 finalisation du projet par des reglages du bras et du detecteur de couleurs
2023-03-17 corrections de commentaires
2023-03-23 map mind des enfants
2023-04-26 nouveau programme du bras avec la bibliotheque easing en cours de tests
2023-05-11 reglages du bras avec le master des trois modules
2023-06-13 extinction des leds du portique apres ramassage du cube par le bras - timothe
